Aarhus-University-MPE/DL20/src/Arduino/SD_Query/SD_Query.ino

/*
    Description

    By
    Mads Rosenhoej Jeppesen - Aarhus 2021
    mrj@mpe.au.dk

    Query data from Drill Logger SD card
*/


#include <SD.h>

const int chipSelect = 10;
bool systemActive;
bool newCommand = false;
String command;

void setup() {
  Serial.begin(115200);
  while (!Serial);

  //Serial.print("Initializing SD card... ");

  if (!SD.begin(chipSelect)) {
    systemActive = false;
    //Serial.println("Connection Failed!");
  }
  else {
    systemActive = true;
    //Serial.println("initialization done.");
  }
}

void loop() {
  if (!systemActive) {
    if (!SD.begin(chipSelect)) {
      systemActive = false;
      //Serial.println("Connection Failed!");
    }
    else {
      systemActive = true;
      //Serial.println("initialization done.");
    }
  }
  recvWithEndMarker();

  delay(250);
}

void printFiles(File dir, int numTabs)
{
  while (true)
  {
    File entry =  dir.openNextFile();
    if (! entry) {
      File entry =  dir.openNextFile();
      if (! entry) break;
    }

    if (!entry.isDirectory()) {
      Serial.print(entry.name());
      Serial.print("\t\t");
      Serial.println(entry.size(), DEC);
    }
    entry.close();
  }
}


// Receive Commands
void recvWithEndMarker() {
  while (Serial.available())
  {
    char c = Serial.read();
    //Serial.print(c);              // Uncomment to see command string flow
    if (c == '<')
    {
      newCommand = true;
    }
    else if (c == '>' && newCommand == true)
    {
      newCommand = false;
      parseCommand(command);
      command = "";
    }
    else if (newCommand == true)
    {
      command += c;
    }
  }
}

// Command handler
void parseCommand(String com)
{
  String part1;
  String part2;
  File file;

  part1 = com.substring(0, com.indexOf('.'));
  part2 = com.substring(com.indexOf('.') + 1);

  if (part1.equalsIgnoreCase("query")) {
    if (part2.equalsIgnoreCase("all")) {
      if (systemActive) {
        Serial.println("Files in system:");
        file = SD.open("/");
        file.rewindDirectory();
        printFiles(file, 0);
        file.rewindDirectory();
        file.close();
        Serial.println("End of storage");
      }
      else Serial.println("SD card connection Error!");
    }
    else {
      Serial.println("NACK");
    }
  }

  else if (part1.equalsIgnoreCase("size")) {
    // part 2 contains file name
    if (systemActive) {
      Serial.println("Opening file: " + part2 + ".txt");
      file = SD.open(part2 + ".txt");
      if (file) {
        Serial.println("File size: " + (String)file.size() + " bytes");
        file.close();
      }
      else Serial.println("File not found!");
    }
    else Serial.println("SD card connection Error!");
  }
  else if (part1.equalsIgnoreCase("download")) {
    if (systemActive) {
      Serial.println("Downloading file: " + part2 + ".txt");
      Serial.println();
      file = SD.open(part2 + ".txt");
      if (file) {
        while (file.available()) {
          Serial.write(file.read());
        }
        file.close();
        Serial.println("End of File");
      }
      else Serial.println("File not found!");
    }
    else Serial.println("SD card connection Error!");
  }
  else if (part1.equalsIgnoreCase("delete")) {
    if (systemActive) {
      if (SD.exists(part2 + ".txt")) {
        Serial.println("Deleting file: " + part2 + ".txt");
        Serial.println();
        SD.remove(part2 + ".txt");
        Serial.println("File Removed");
      }
      else Serial.println("File not found");
    }
    else Serial.println("SD card connection Error!");
  }

  else if (part1.equalsIgnoreCase("create")) {
    if (systemActive) {
      if (SD.exists(part2 + ".txt")) {
        Serial.println("File already exist");
      }
      else {
        Serial.println("Creating file: " + part2 + ".txt");
        file = SD.open(part2 + ".txt", FILE_WRITE);
        file.close();
      }
    }
    else Serial.println("SD card connection Error!");
  }
  else Serial.println("NACK");
}
