Aarhus-University-MPE/DL20/(commit log)

2021-07-05 SD reader and software SPI lock fix
    [DrillLogger.ino, SD_Query.ino]
2021-07-12 Calibration Test
2021-07-14 Calibration folder removed
